arsdorintbp2003/EG1311-Group-Project/README.md

# EG1311-Group-Project
My Group Project of EG1311 AY2021/2022 Sem 2
